armesis/vespasian_board/docs/kelvin-sense-reference.png

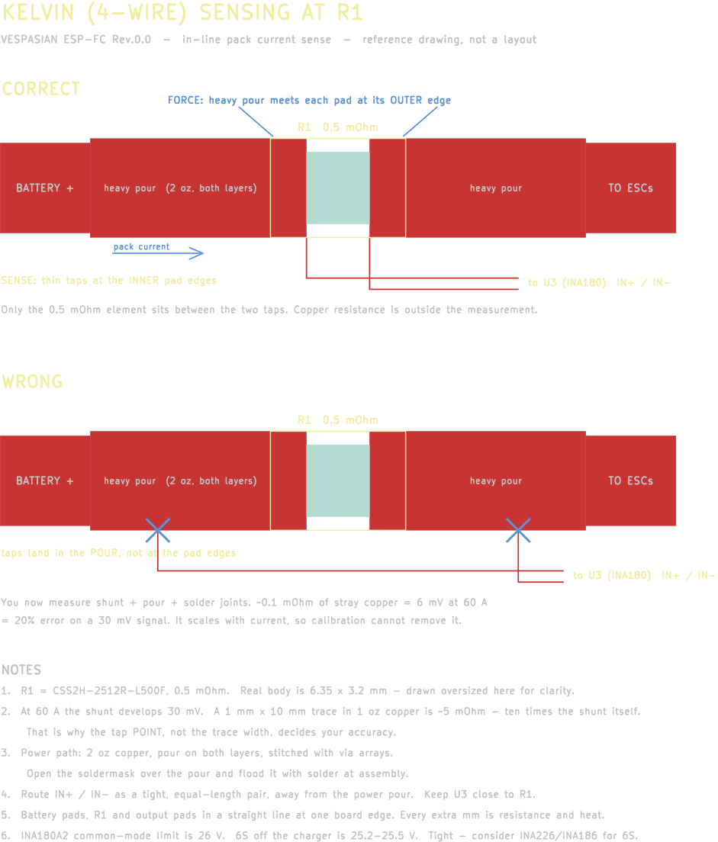
docs/kelvin-sense-reference.png
