armesis/vespasian_board/ESP-FC Rev.0.0.pdf

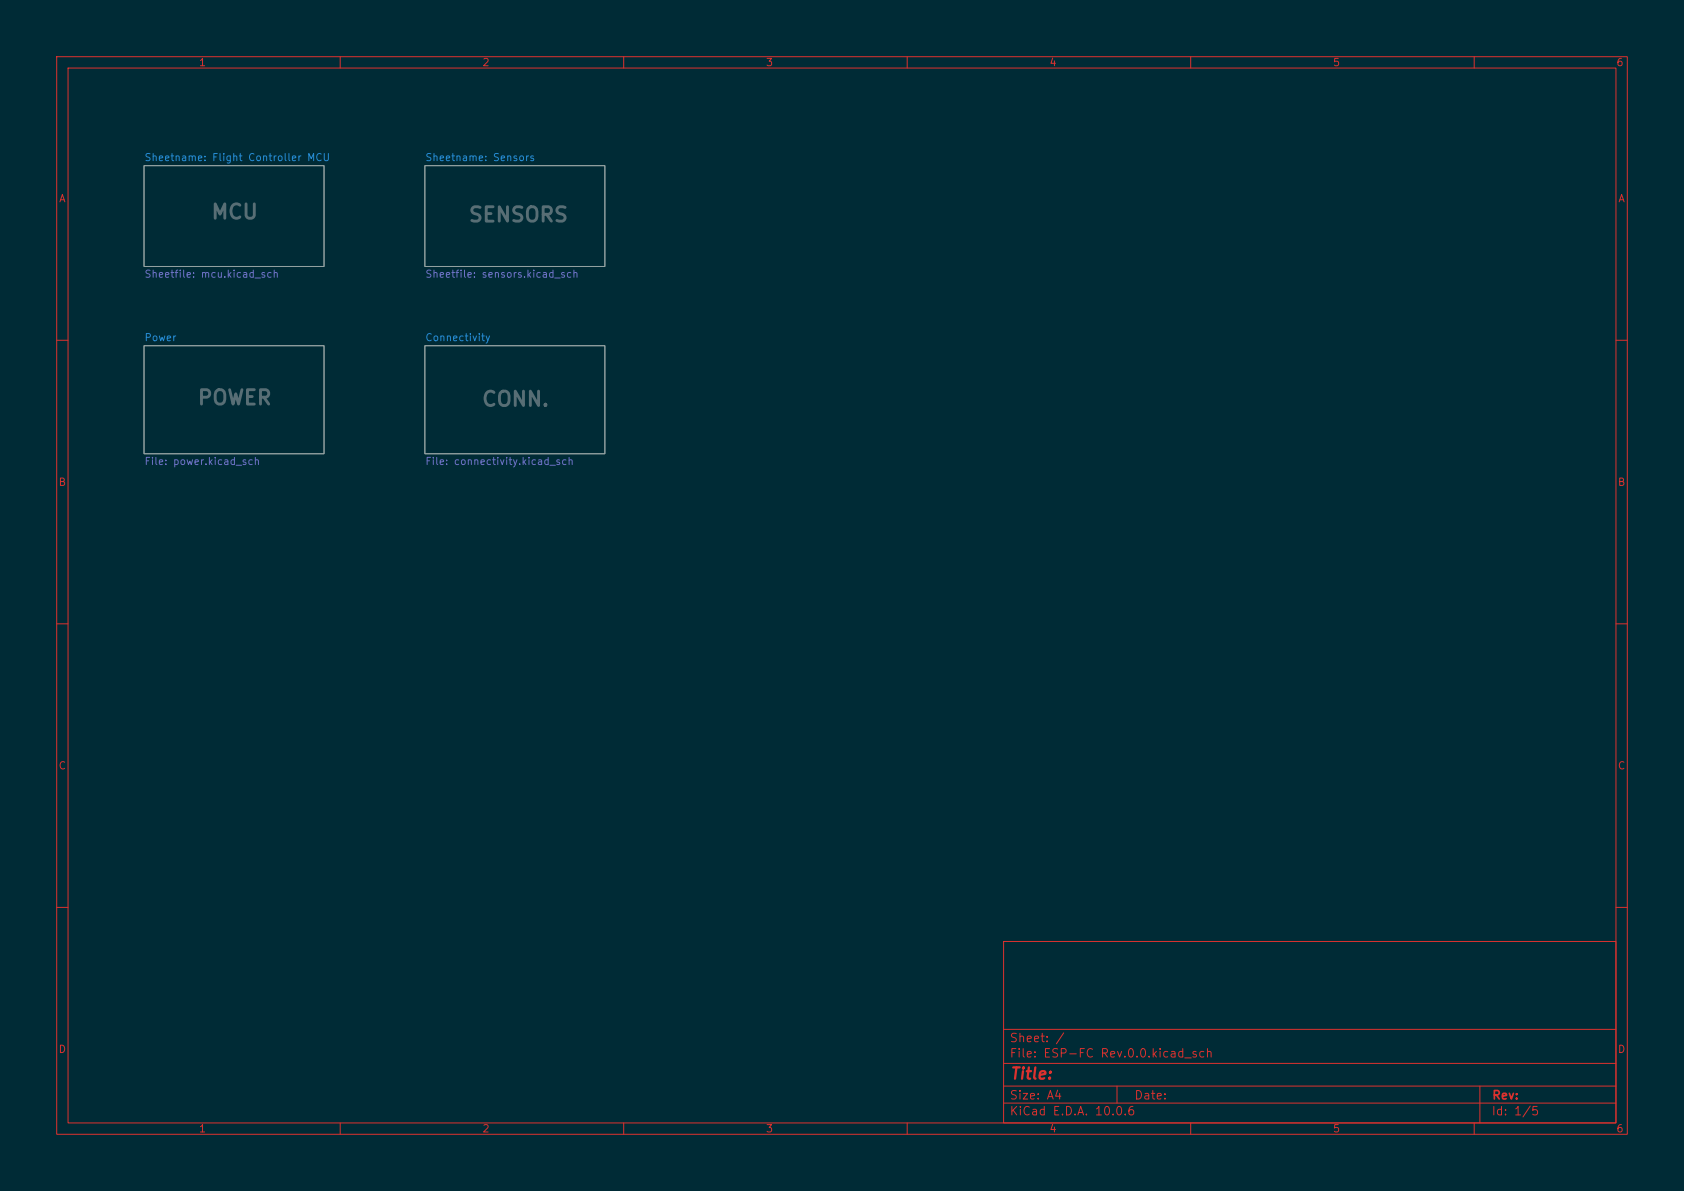
[picture p2: page 1]

Sheetname: Flight Controller MCU

Sheetname: Sensors Sheetfile: sensors.kicad_sch SENSORS

Sheet: /
File: ESP-FC Rev.0.0.kicad_sch
Title:

Size: A4 | Rev:
KiCad E.D.A. 10.0.6 | Id: 1/5

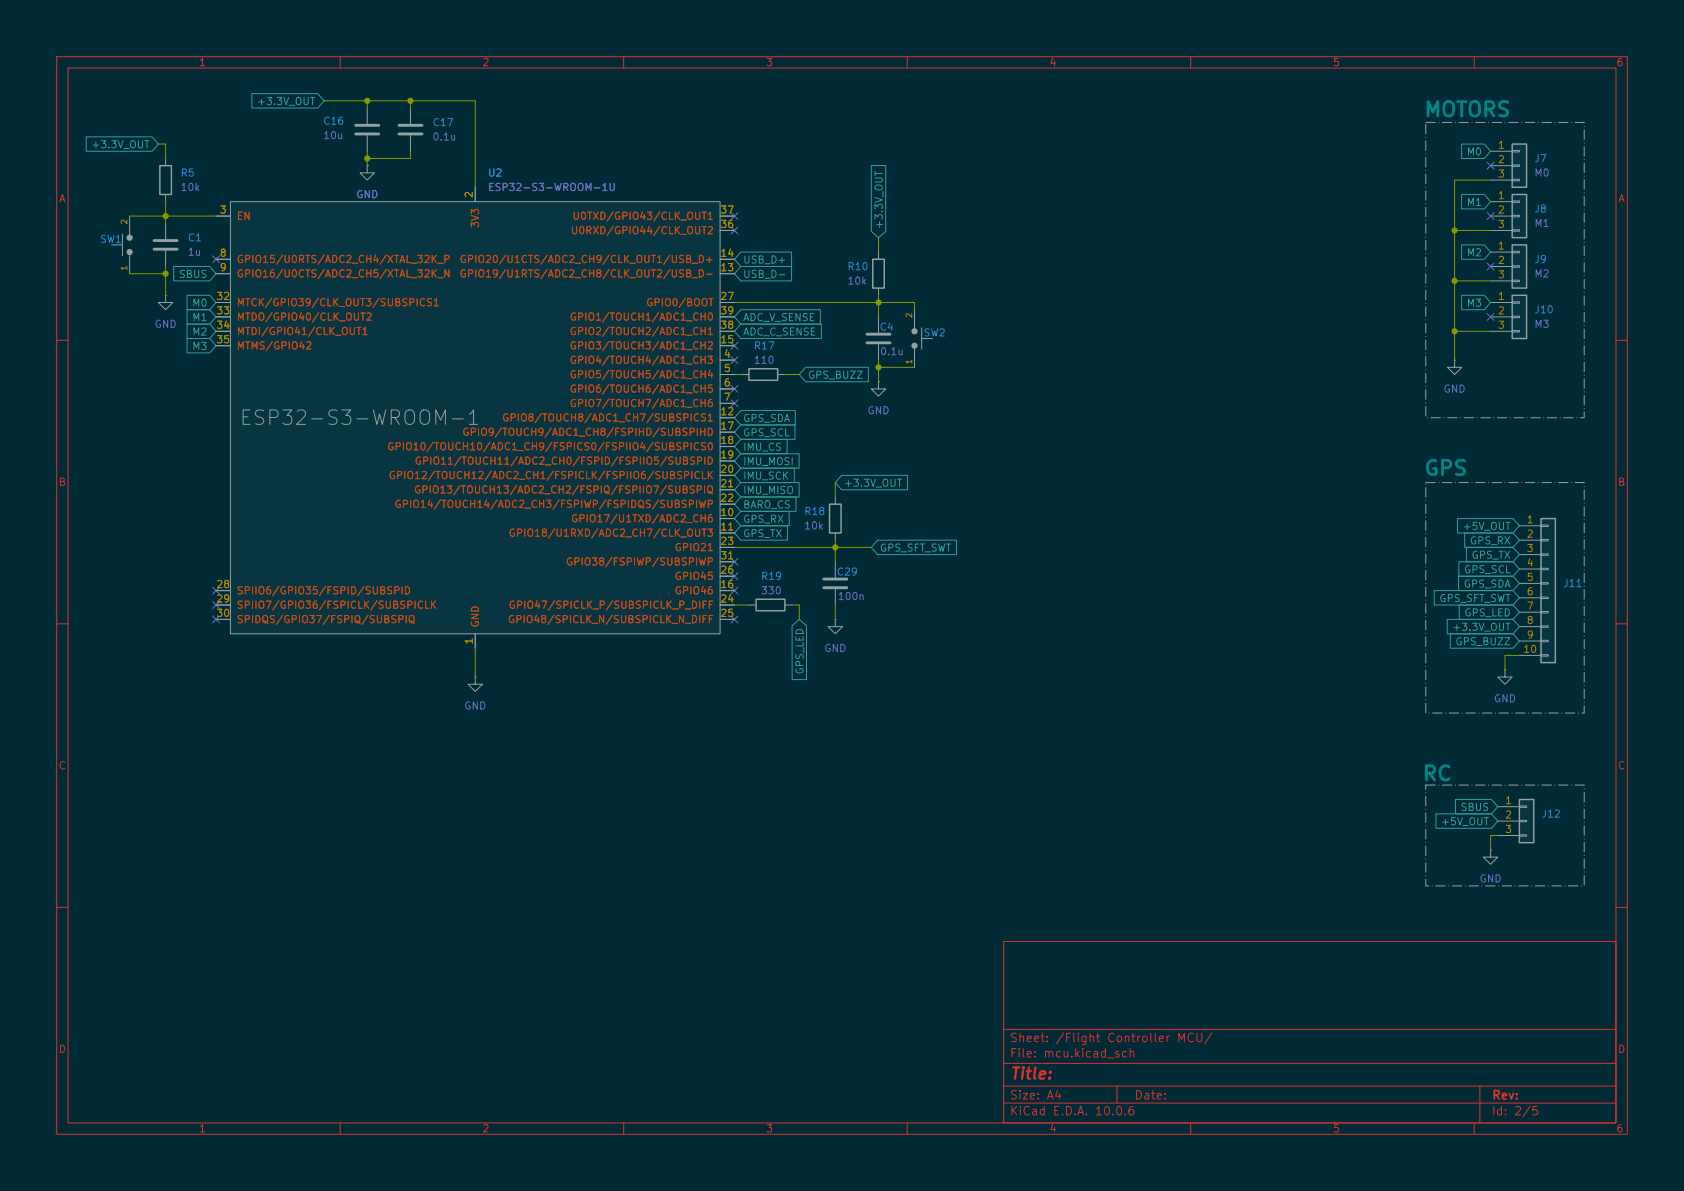
[picture p3: page 2]

Sheet: /Flight Controller MCU/
File: mcu.kicad_sch
Title:

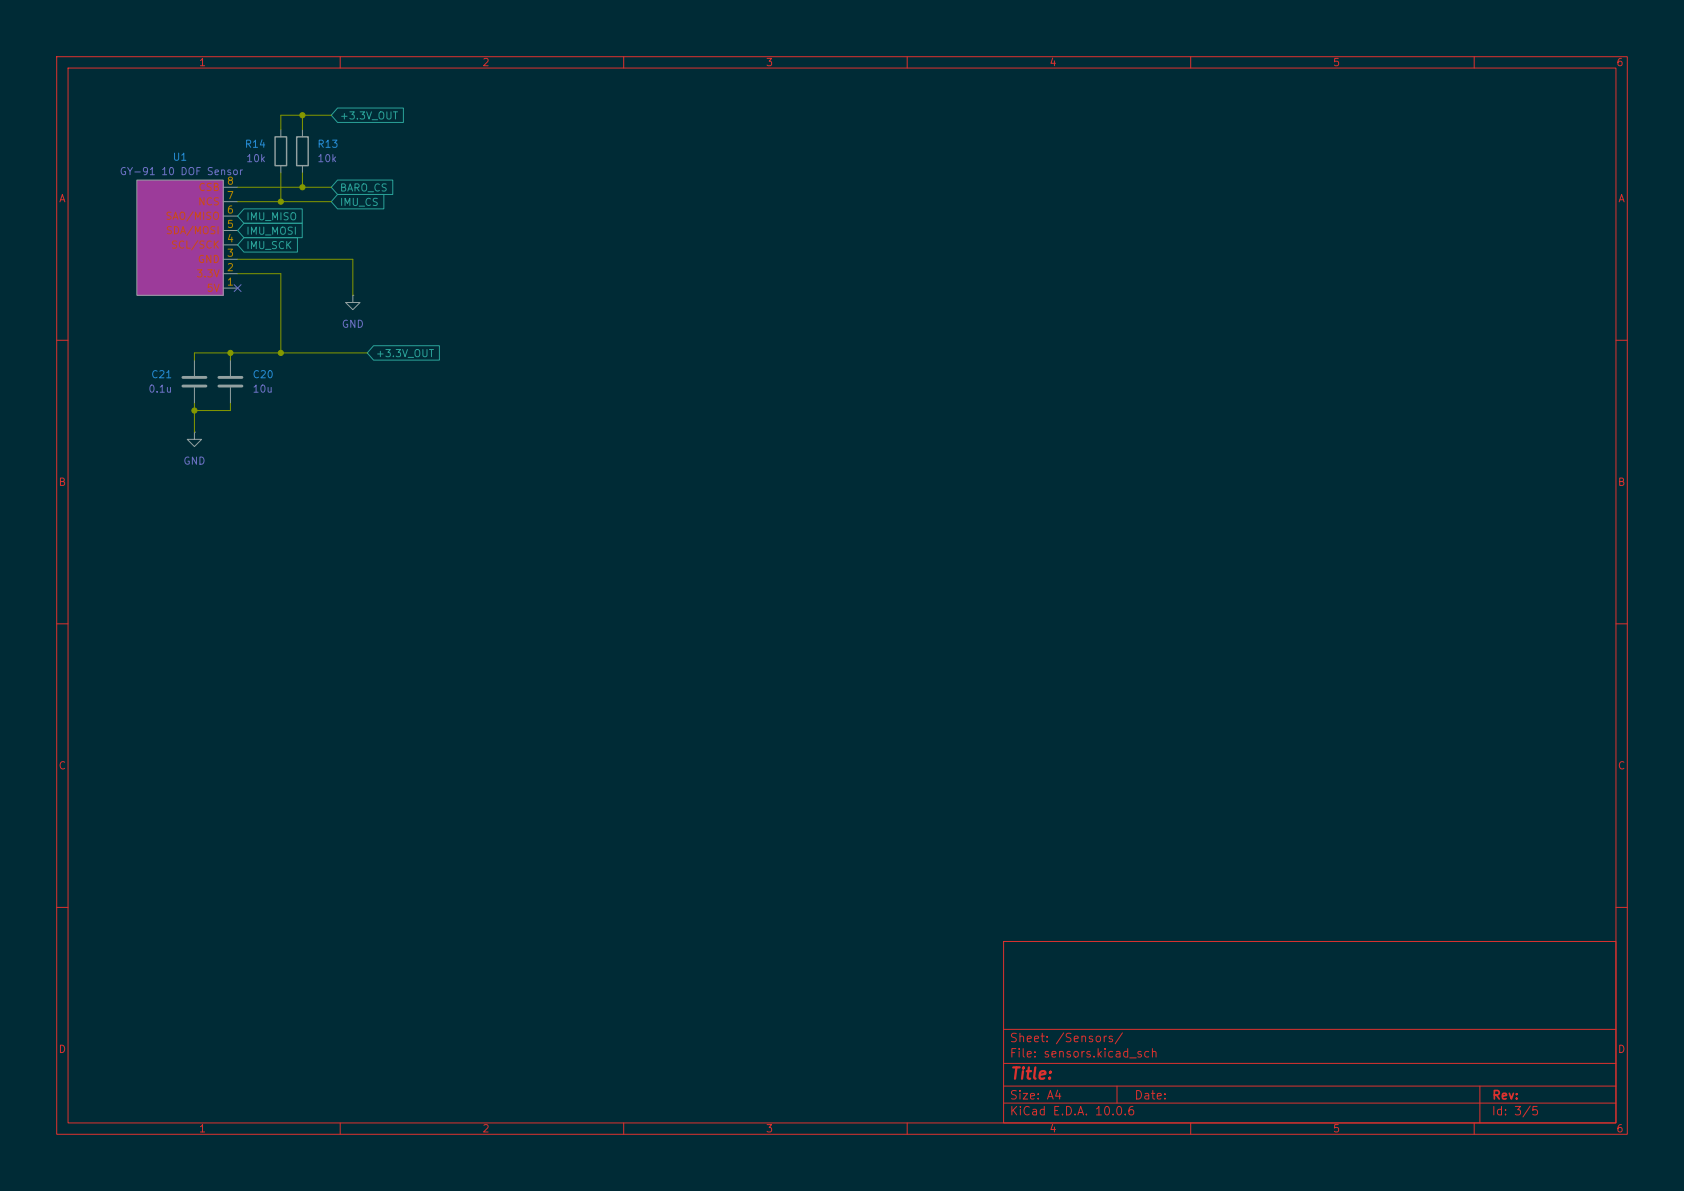
[picture p4: page 3]

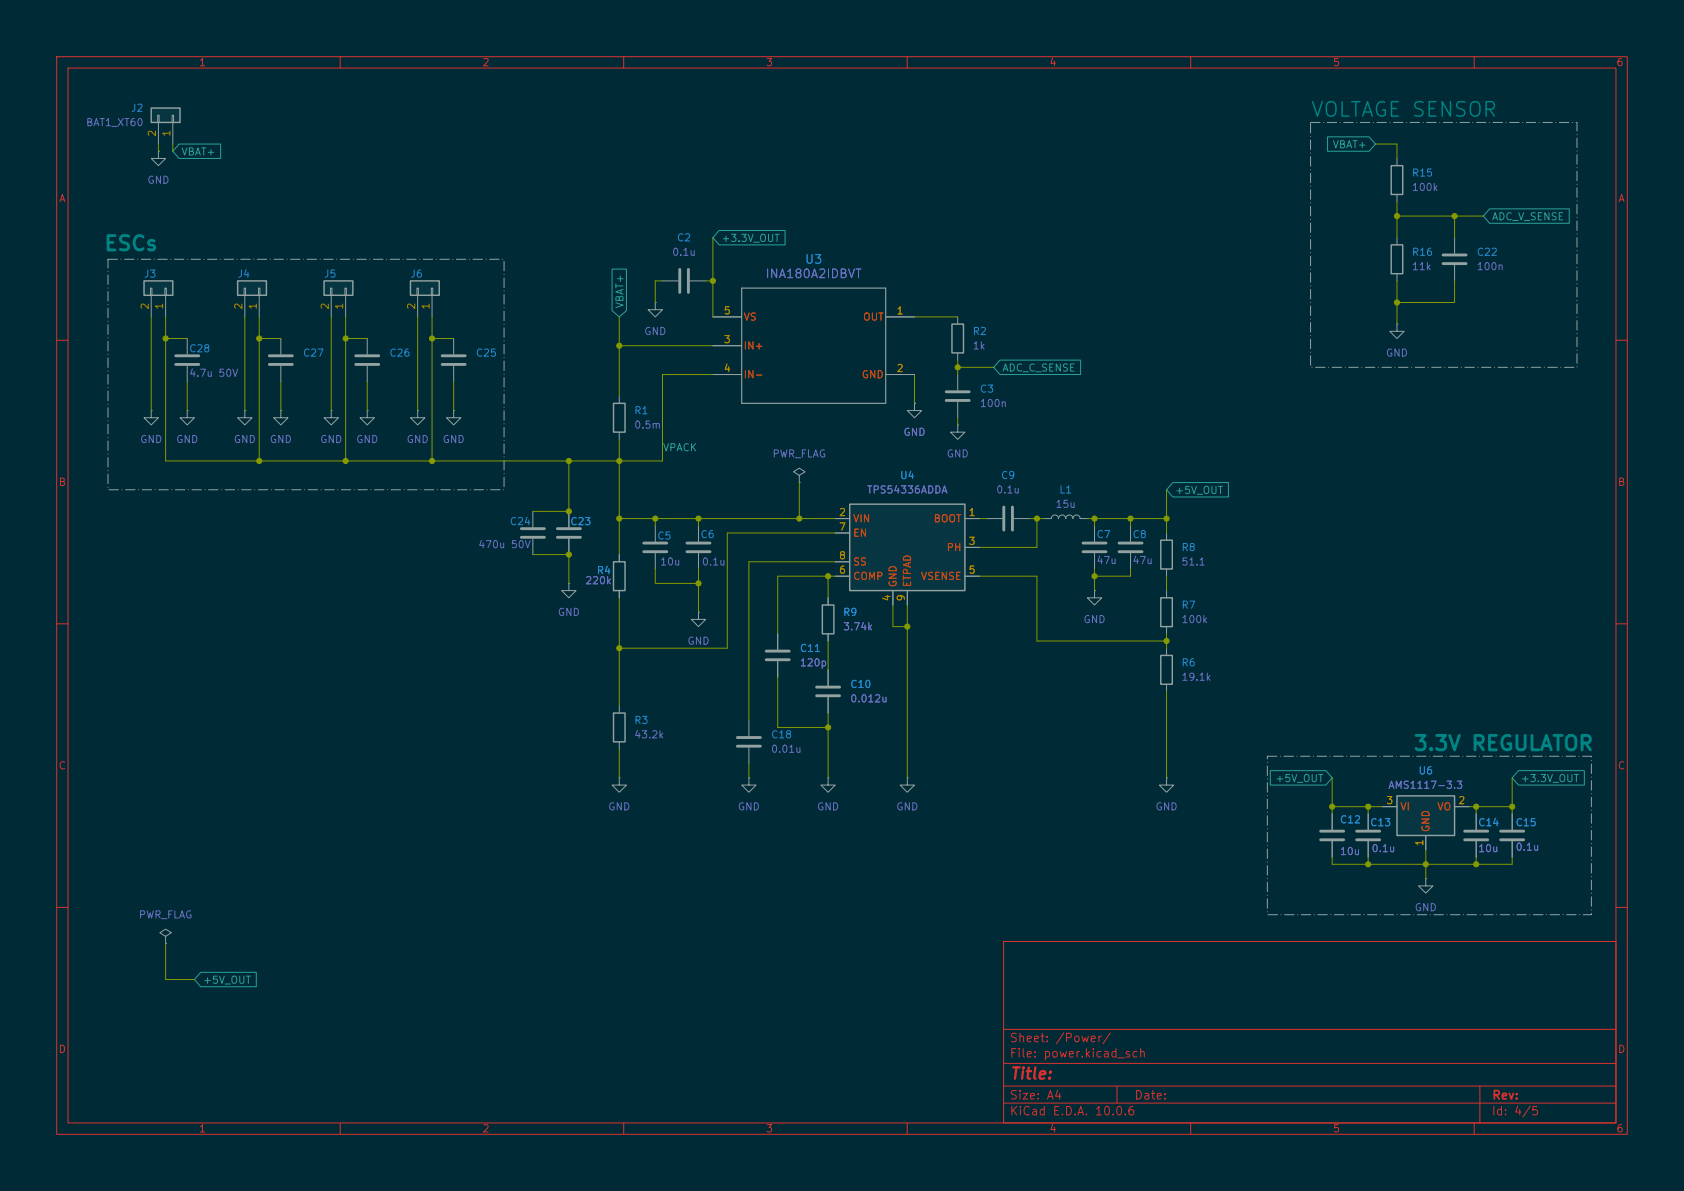
[picture p5: page 4]

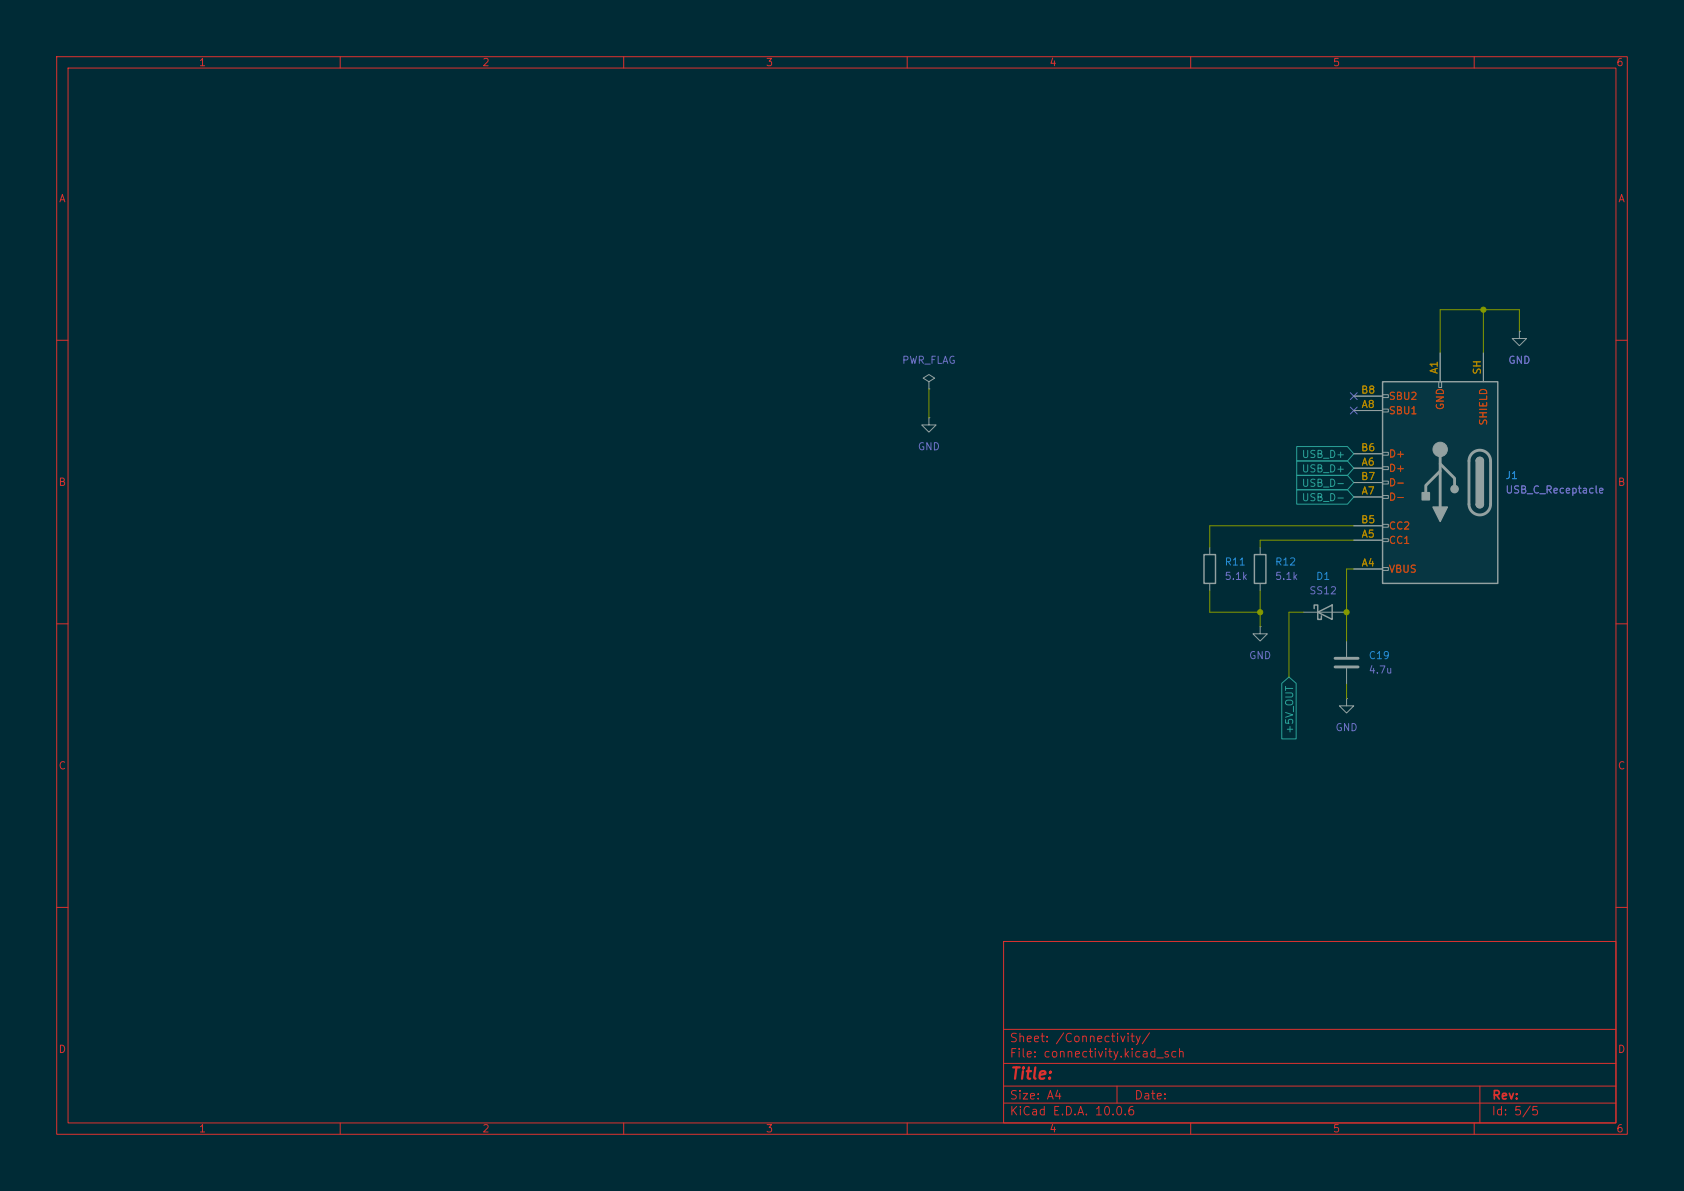
[picture p6: page 5]
