armesis/vespasian_board/ESP-FC Rev.0.0.kicad_pcb

## KiCad design ESP-FC Rev.0.0.kicad_pcb (2026-09-18)

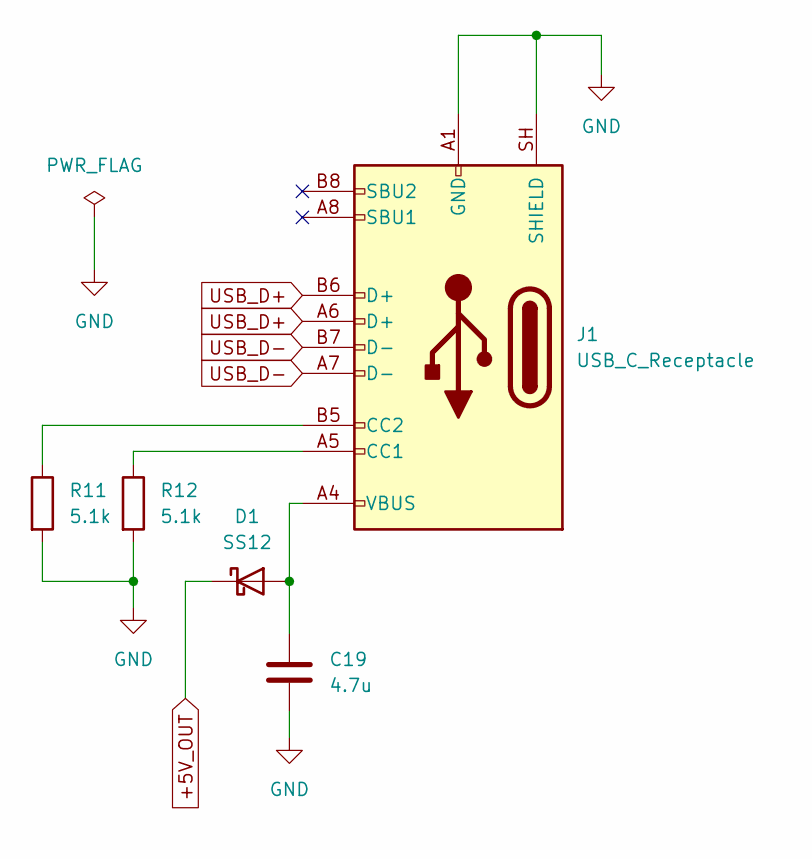
[picture p7: schematic connectivity.kicad_sch]

Parts:
C19: 4.7u; C_0805_2012Metric_Pad1.18x1.45mm_HandSolder
D1: SS12; D_SMA_Handsoldering
J1: USB_C_Receptacle; USB_C_Receptacle_XKB_U262-16XN-4BVC11
R11, R12: 5.1k; R_0603_1608Metric_Pad0.98x0.95mm_HandSolder

Connections:
+5V_OUT: D1.1 (K); also elsewhere on the board
GND: C19.2, J1.A1 (GND), J1.A12 (GND), J1.B1 (GND), J1.B12 (GND), J1.SH (SHIELD), R11.2, R12.2; also elsewhere on the board
unnamed: C19.1, D1.2 (A), J1.A4 (VBUS), J1.A9 (VBUS), J1.B4 (VBUS), J1.B9 (VBUS)
unnamed: J1.A5 (CC1), R12.1
unnamed: J1.B5 (CC2), R11.1
USB_D+: J1.A6 (D+), J1.B6 (D+); also elsewhere on the board
USB_D-: J1.A7 (D-), J1.B7 (D-); also elsewhere on the board

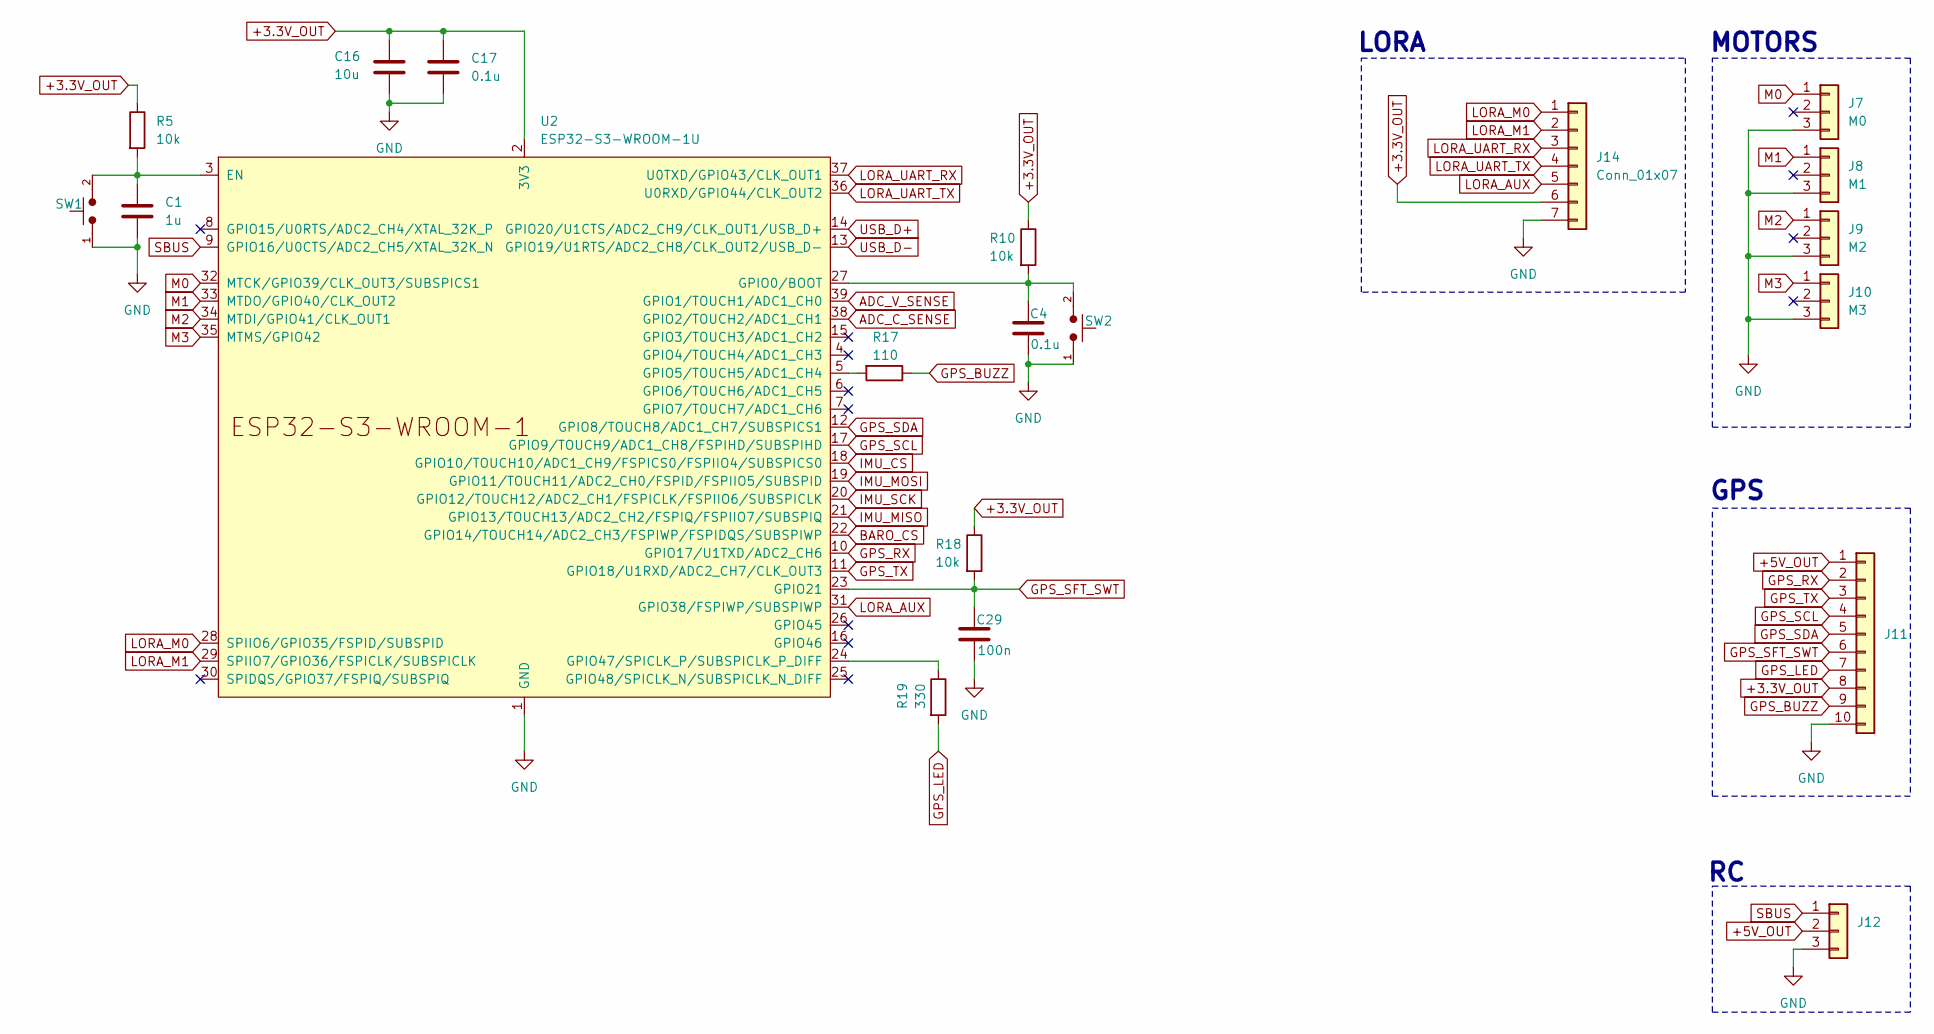
[picture p8: schematic mcu.kicad_sch]

Parts:
C1: 1u; C_0603_1608Metric_Pad1.08x0.95mm_HandSolder
C4, C17: 0.1u; C_0603_1608Metric_Pad1.08x0.95mm_HandSolder
C16: 10u; C_0805_2012Metric_Pad1.18x1.45mm_HandSolder
C29: 100n; C_0603_1608Metric_Pad1.08x0.95mm_HandSolder
J7: M0; PinHeader_1x03_P2.54mm_Horizontal
J8: M1; PinHeader_1x03_P2.54mm_Horizontal
J9: M2; PinHeader_1x03_P2.54mm_Horizontal
J10: M3; PinHeader_1x03_P2.54mm_Horizontal
J11: Conn_01x10; JST_GH_BM10B-GHS-TBT_1x10-1MP_P1.25mm_Vertical
J12: Conn_01x03; PinHeader_1x03_P2.54mm_Horizontal
J14: Conn_01x07; PinHeader_1x07_P2.54mm_Horizontal
R5, R10, R18: 10k; R_0603_1608Metric_Pad0.98x0.95mm_HandSolder
R17: 110; R_0603_1608Metric_Pad0.98x0.95mm_HandSolder
R19: 330; R_0603_1608Metric_Pad0.98x0.95mm_HandSolder
SW1, SW2: Push_Button; SW_PUSH_6mm
U2: ESP32-S3-WROOM-1U

Connections:
+3.3V_OUT: C16.1, C17.1, J11.8, J14.6, R5.1, R10.1, R18.1, U2.2 (3V3); also elsewhere on the board
+5V_OUT: J11.1, J12.2; also elsewhere on the board
ADC_C_SENSE: U2.38 (GPIO2/TOUCH2/ADC1_CH1); also elsewhere on the board
ADC_V_SENSE: U2.39 (GPIO1/TOUCH1/ADC1_CH0); also elsewhere on the board
BARO_CS: U2.22 (GPIO14/TOUCH14/ADC2_CH3/FSPIWP/FSPIDQS/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); also elsewhere on the board
GND: C1.2, C4.2, C16.2, C17.2, C29.2, J7.3, J8.3, J9.3, J10.3, J11.10, J12.3, J14.7, SW1.1, SW2.1, U2.1 (GND), U2.40 (GND), U2.41 (GND); also elsewhere on the board
GPS_BUZZ: J11.9, R17.1
GPS_LED: J11.7, R19.2
GPS_RX: J11.2, U2.10 (GPIO17/U1TXD/ADC2_CH6)
GPS_SCL: J11.4, U2.17 (GPIO9/TOUCH9/ADC1_CH8/FSPIHD/SUBSPIHD)
GPS_SDA: J11.5, U2.12 (GPIO8/TOUCH8/ADC1_CH7/SUBSPICS1)
GPS_SFT_SWT: C29.1, J11.6, R18.2, U2.23 (GPIO21)
GPS_TX: J11.3, U2.11 (GPIO18/U1RXD/ADC2_CH7/CLK_OUT3)
IMU_CS: U2.18 (GPIO10/TOUCH10/ADC1_CH9/FSPICS0/FSPIIO4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); also elsewhere on the board
IMU_MISO: U2.21 (GPIO13/TOUCH13/ADC2_CH2/FSPIQ/FSPIIO7/S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); also elsewhere on the board
IMU_MOSI: U2.19 (GPIO11/TOUCH11/ADC2_CH0/FSPID/FSPIIO5/S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); also elsewhere on the board
IMU_SCK: U2.20 (GPIO12/TOUCH12/ADC2_CH1/FSPICLK/FSPIIO6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); also elsewhere on the board
LORA_AUX: J14.5, U2.31 (GPIO38/FSPIWP/SUBSPIWP)
LORA_M0: J14.1, U2.28 (SPIIO6/GPIO35/FSPID/SUBSPID)
LORA_M1: J14.2, U2.29 (SPIIO7/GPIO36/FSPICLK/SUBSPICLK)
LORA_UART_RX: J14.3, U2.37 (U0TXD/GPIO43/CLK_OUT1)
LORA_UART_TX: J14.4, U2.36 (U0RXD/GPIO44/CLK_OUT2)
M0: J7.1, U2.32 (MTCK/GPIO39/CLK_OUT3/SUBSPICS1)
M1: J8.1, U2.33 (MTDO/GPIO40/CLK_OUT2)
M2: J9.1, U2.34 (MTDI/GPIO41/CLK_OUT1)
M3: J10.1, U2.35 (MTMS/GPIO42)
unnamed: C1.1, R5.2, SW1.2, U2.3 (EN)
unnamed: C4.1, R10.2, SW2.2, U2.27 (GPIO0/BOOT)
unnamed: R17.2, U2.5 (GPIO5/TOUCH5/ADC1_CH4)
unnamed: R19.1, U2.24 (GPIO47/SPICLK_P/SUBSPICLK_P_DIFF)
SBUS: J12.1, U2.9 (GPIO16/U0CTS/ADC2_CH5/XTAL_32K_N)
USB_D+: U2.14 (GPIO20/U1CTS/ADC2_CH9/CLK_OUT1/USB_D+); also elsewhere on the board
USB_D-: U2.13 (GPIO19/U1RTS/ADC2_CH8/CLK_OUT2/USB_D-); also elsewhere on the board

Notes on the sheet:
LORA
MOTORS
GPS

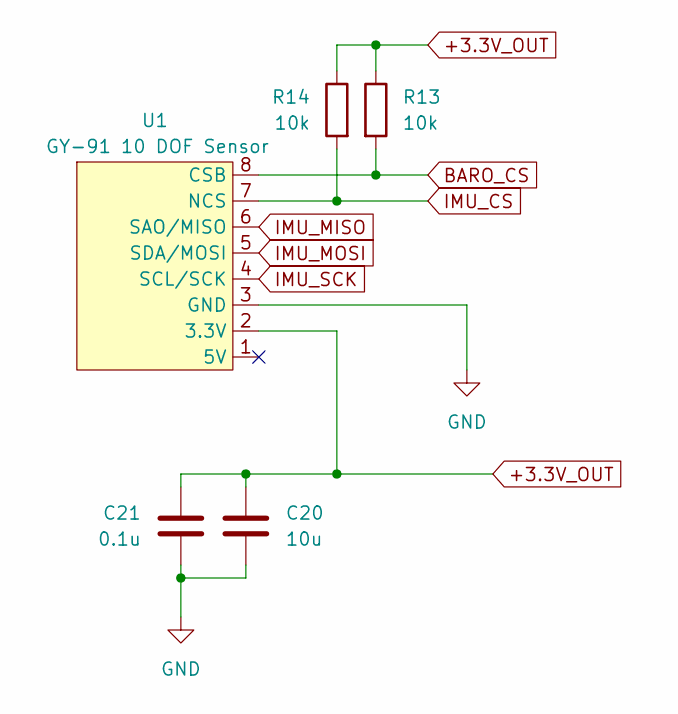
[picture p9: schematic sensors.kicad_sch]

Parts:
C20: 10u; C_0603_1608Metric_Pad1.08x0.95mm_HandSolder
C21: 0.1u; C_0603_1608Metric_Pad1.08x0.95mm_HandSolder
R13, R14: 10k; R_0603_1608Metric_Pad0.98x0.95mm_HandSolder
U1: GY-91 10 DOF Sensor; GY-91

Connections:
+3.3V_OUT: C20.1, C21.1, R13.1, R14.1, U1.2 (3.3V); also elsewhere on the board
BARO_CS: R13.2, U1.8 (CSB); also elsewhere on the board
GND: C20.2, C21.2, U1.3 (GND); also elsewhere on the board
IMU_CS: R14.2, U1.7 (NCS); also elsewhere on the board
IMU_MISO: U1.6 (SAO/MISO); also elsewhere on the board
IMU_MOSI: U1.5 (SDA/MOSI); also elsewhere on the board
IMU_SCK: U1.4 (SCL/SCK); also elsewhere on the board

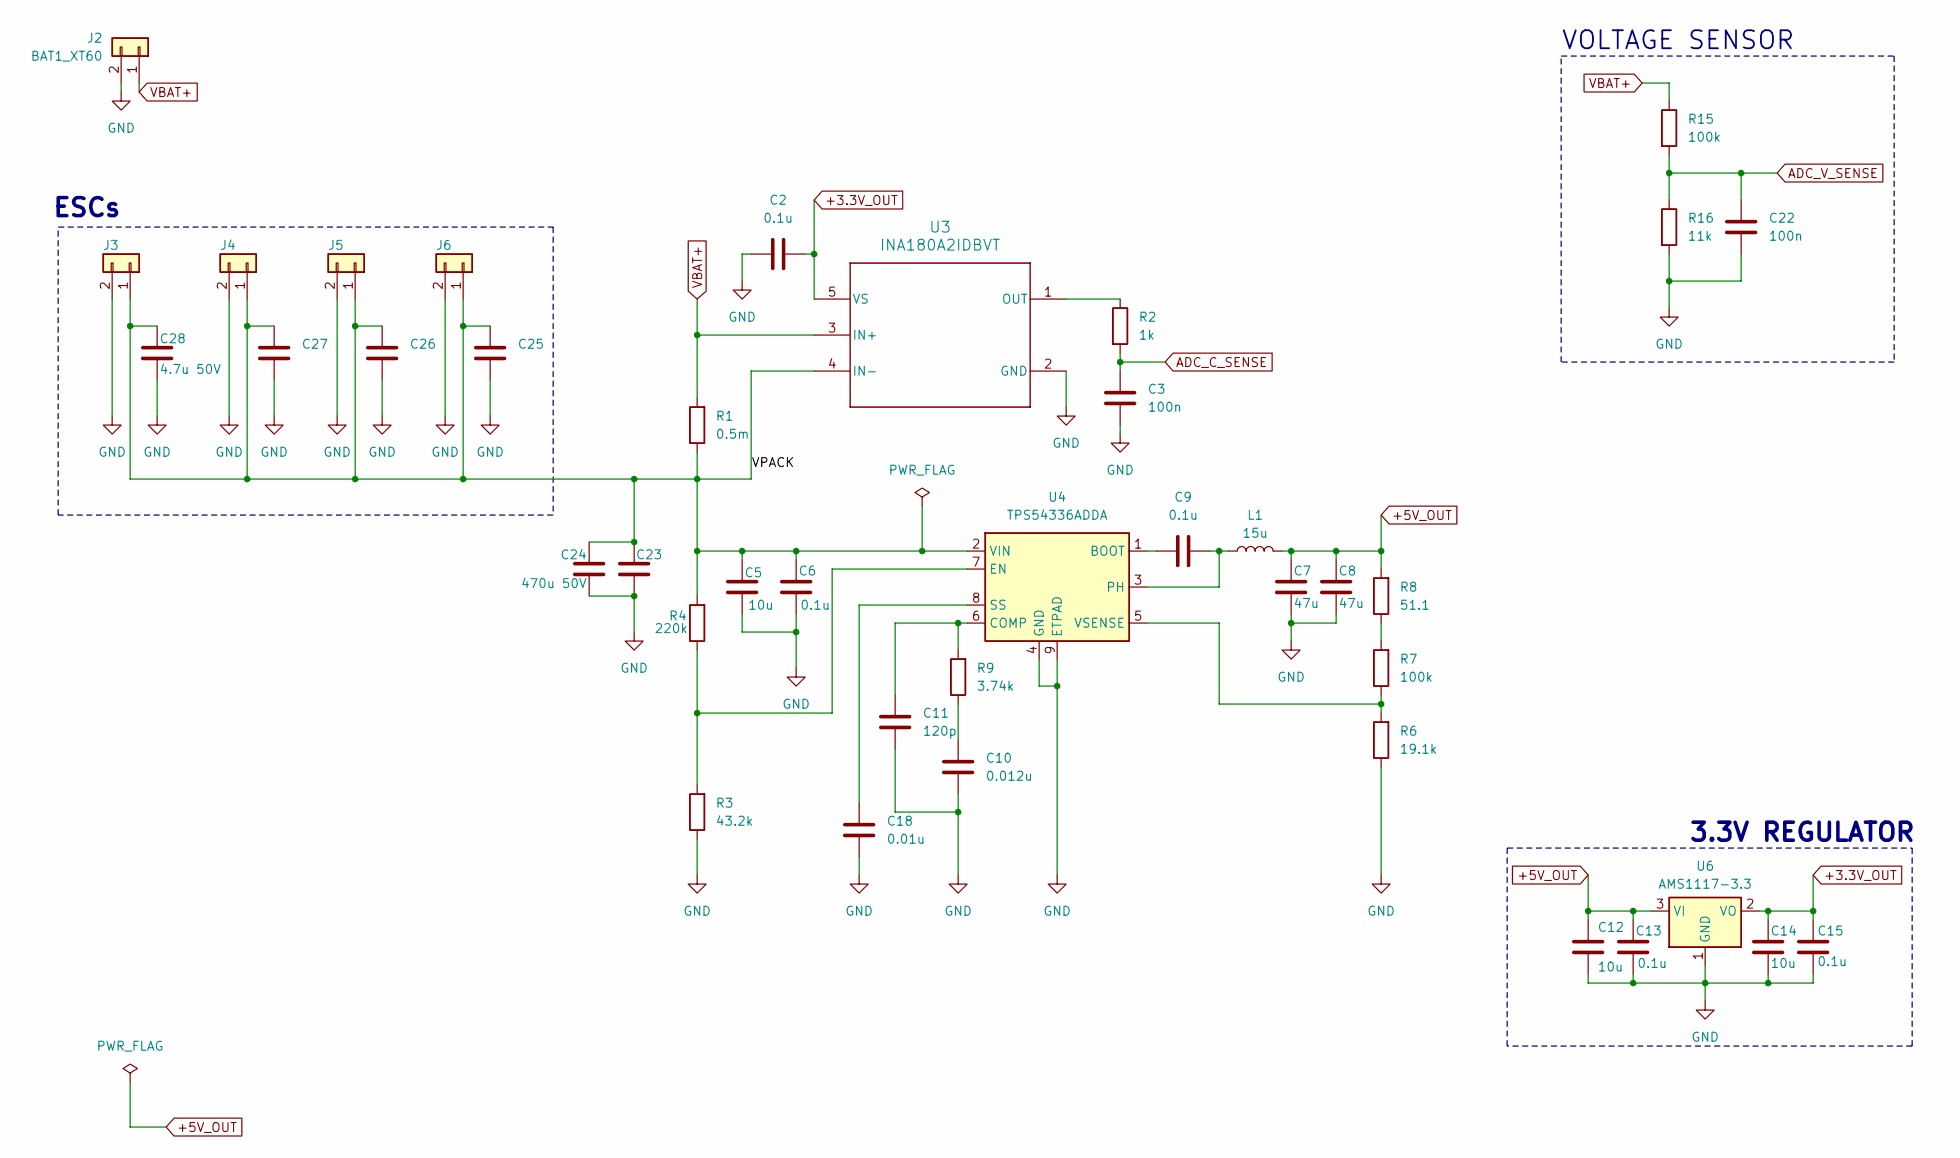
[picture p10: schematic power.kicad_sch]

Parts:
C2: 0.1u; C_0603_1608Metric
C3, C22: 100n; C_0603_1608Metric_Pad1.08x0.95mm_HandSolder
C5: 10u; C_1206_3216Metric_Pad1.33x1.80mm_HandSolder
C6, C9, C13, C15: 0.1u; C_0603_1608Metric_Pad1.08x0.95mm_HandSolder
C7, C8: 47u; C_1210_3225Metric_Pad1.33x2.70mm_HandSolder
C10: 0.012u; C_0603_1608Metric_Pad1.08x0.95mm_HandSolder
C11: 120p; C_0603_1608Metric_Pad1.08x0.95mm_HandSolder
C12, C14: 10u; C_0805_2012Metric_Pad1.18x1.45mm_HandSolder
C18: 0.01u; C_0603_1608Metric_Pad1.08x0.95mm_HandSolder
C23, C24: 470u 50V; CP_Radial_D10.0mm_P5.00mm
C25, C26, C27, C28: 4.7u 50V; C_1206_3216Metric_Pad1.33x1.80mm_HandSolder
J2: BAT1_XT60; AMASS_XT60PW-M_1x02_P7.20mm_Horizontal
J3, J4, J5, J6: Conn_01x02; AMASS_XT30PW-F_1x02_P2.50mm_Horizontal
L1: 15u; L_APV_APH0630
R1: 0.5m; RES_L500x_BRN
R2: 1k; R_0805_2012Metric
R3: 43.2k; R_0603_1608Metric_Pad0.98x0.95mm_HandSolder
R4: 220k; R_0603_1608Metric_Pad0.98x0.95mm_HandSolder
R6: 19.1k; R_0603_1608Metric_Pad0.98x0.95mm_HandSolder
R7, R15: 100k; R_0603_1608Metric_Pad0.98x0.95mm_HandSolder
R8: 51.1; R_0603_1608Metric_Pad0.98x0.95mm_HandSolder
R9: 3.74k; R_0603_1608Metric_Pad0.98x0.95mm_HandSolder
R16: 11k; R_0603_1608Metric_Pad0.98x0.95mm_HandSolder
U3: INA180A2IDBVT; DBV0005A_N
U4: TPS54336ADDA; TI_SO-PowerPAD-8_ThermalVias
U6: AMS1117-3.3; SOT-223-3_TabPin2

Connections:
+3.3V_OUT: C2.2, C14.1, C15.1, U3.5 (VS), U6.2 (VO); also elsewhere on the board
+5V_OUT: C7.1, C8.1, C12.1, C13.1, L1.2, R8.2, U6.3 (VI); also elsewhere on the board
/Power/VPACK: C5.1, C6.1, C23.2, C24.2, C25.2, C26.2, C27.2, C28.2, J3.1, J4.1, J5.1, J6.1, R1.1, R4.2, U3.4 (IN-), U4.2 (VIN)
ADC_C_SENSE: C3.1, R2.2; also elsewhere on the board
ADC_V_SENSE: C22.1, R15.2, R16.1; also elsewhere on the board
GND: C2.1, C3.2, C5.2, C6.2, C7.2, C8.2, C10.2, C11.2, C12.2, C13.2, C14.2, C15.2, C18.2, C22.2, C23.1, C24.1, C25.1, C26.1, C27.1, C28.1, J2.2, J3.2, J4.2, J5.2, J6.2, R3.1, R6.1, R16.2, U3.2 (GND), U4.4 (GND), U4.9 (ETPAD), U6.1 (GND); also elsewhere on the board
unnamed: C10.1, R9.1
unnamed: R7.2, R8.1
unnamed: R2.1, U3.1 (OUT)
unnamed: C9.1, U4.1 (BOOT)
unnamed: C11.1, R9.2, U4.6 (COMP)
unnamed: R3.2, R4.1, U4.7 (EN)
unnamed: C9.2, L1.1, U4.3 (PH)
unnamed: C18.1, U4.8 (SS)
unnamed: R6.2, R7.1, U4.5 (VSENSE)
VBAT+: J2.1, R1.2, R15.1, U3.3 (IN+)

Notes on the sheet:
VOLTAGE SENSOR
ESCs
3.3V REGULATOR

Board: 2 copper layers, 70 parts (0 on the bottom side), 47 nets, no tracks yet.
