armesis/vespasian_board/(commit log)

2026-09-06 power sch. done, MCU powering as well
    [ESP-FC Rev.0.0.kicad_sch, connectivity.kicad_sch, mcu.kicad_sch, power.kicad_sch]
2026-09-06 Small ammendments
    [ESP-FC Rev.0.0.kicad_sch, connectivity.kicad_sch, mcu.kicad_sch, power.kicad_sch, sensors.kicad_sch]
2026-09-08 ESCs connectors and proper current sensing implemented
    [power.kicad_sch]
2026-09-08 8.09.2026 - 18:56
    [ESP-FC Rev.0.0.kicad_pcb, power.kicad_sch]
2026-09-08 8.09.2026 - 19:33
    [mcu.kicad_sch, power.kicad_sch]
2026-09-08 8.09.2026 - 20:26
    [ESP-FC Rev.0.0.kicad_pcb, mcu.kicad_sch, power.kicad_sch]
2026-09-08 8.09.2026 - 23:26
    [ESP-FC Rev.0.0.kicad_pcb, mcu.kicad_sch]
2026-09-08 9.09.2026 - 00:22
    [mcu.kicad_sch]
2026-09-08 9.09.2026 - 00:29
    [ESP-FC Rev.0.0.kicad_pcb]
2026-09-15 15.09.2026 19:13
    [kelvin-sense-reference.kicad_pcb, mcu.kicad_sch]
2026-09-15 15.09.2026 - 21:22
    [connectivity.kicad_sch, mcu.kicad_sch, power.kicad_sch, sensors.kicad_sch]
2026-09-15 15.09.2026 21:50
    [ESP-FC Rev.0.0.kicad_pcb, connectivity.kicad_sch, mcu.kicad_sch, power.kicad_sch, sensors.kicad_sch]
2026-09-15 15.09.2026 - 21:55
    [ESP-FC Rev.0.0.kicad_pcb, power.kicad_sch]
2026-09-18 18.09.2026 20:58
    [ESP-FC Rev.0.0.kicad_pcb, power.kicad_sch]
2026-09-18 19.09.2026 00:53
    [ESP-FC Rev.0.0.kicad_pcb, connectivity.kicad_sch, mcu.kicad_sch]
